KerbalJeb/ECE299DesignProject/README.md

# ECE299DesignProject


An Arduino Uno power alarm clock, complated as part of ECE299 at UVic.

The PCB desing files can be viewed online at:[CADLAB.io](https://cadlab.io/project/23071).
