KerbalJeb/ECE299DesignProject/Report/Schematic Arduino2.PNG

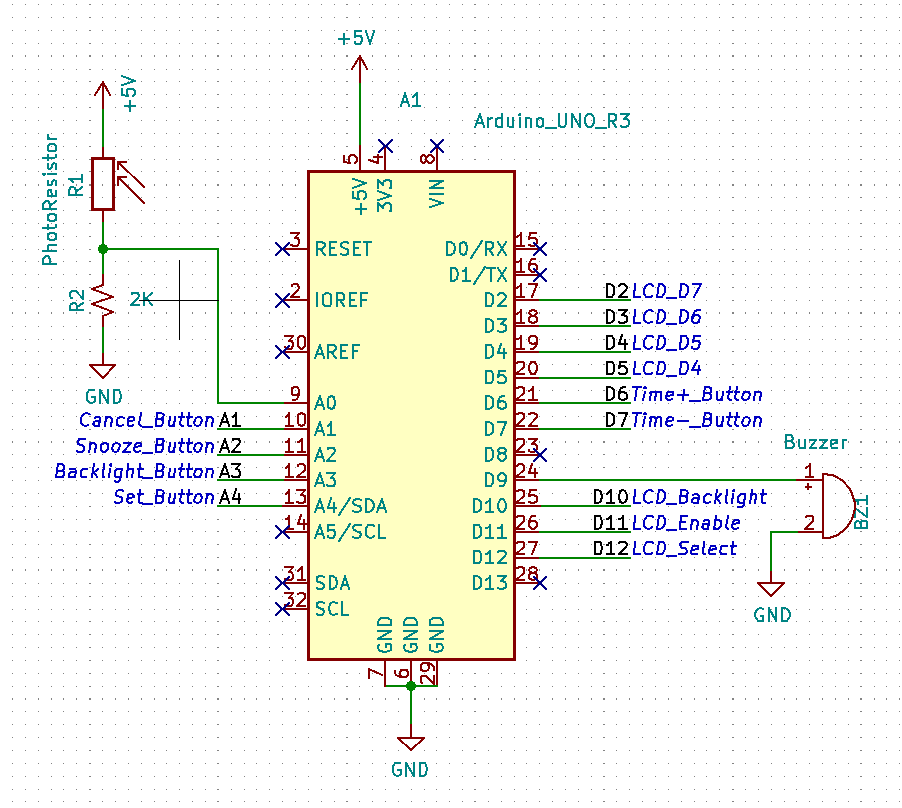
Report/Schematic Arduino2.PNG
