KerbalJeb/ECE299DesignProject/Report/Schematic Arduino.PNG

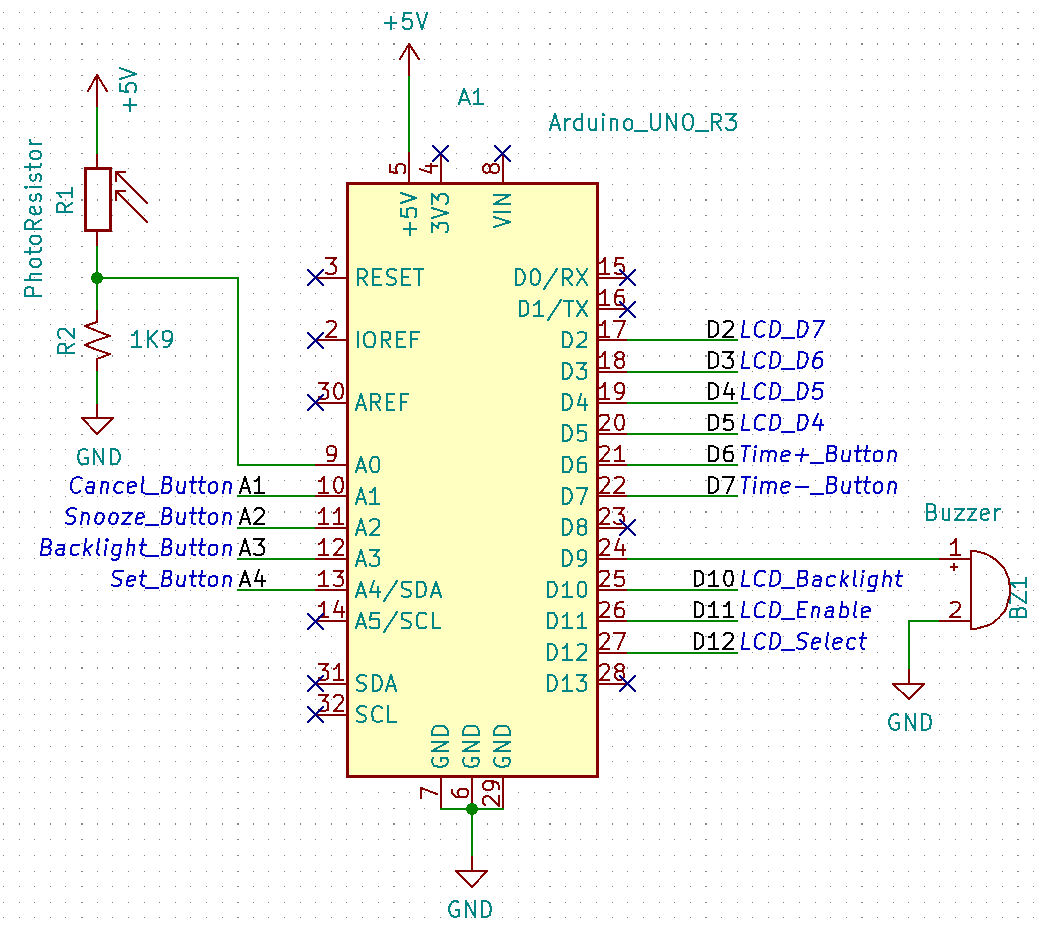
Report/Schematic Arduino.PNG
