KerbalJeb/ECE299DesignProject/Report/Schematic General.PNG

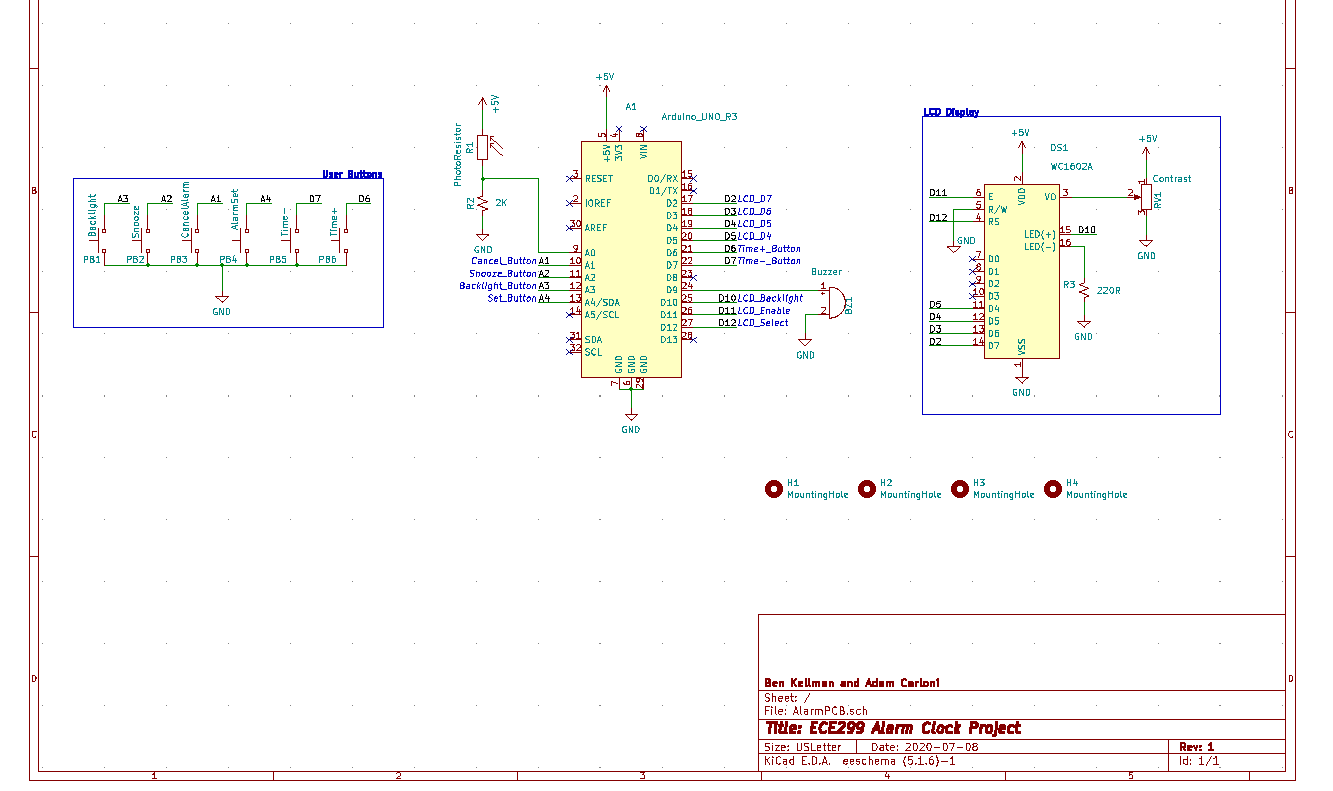
Report/Schematic General.PNG
