KerbalJeb/ECE299DesignProject/Report/Schematic LCD Drawing.PNG

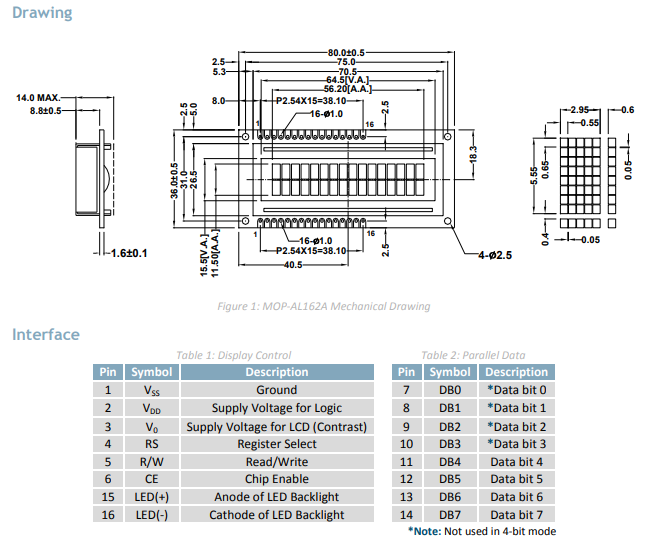
Report/Schematic LCD Drawing.PNG
