KerbalJeb/ECE299DesignProject/Report/Schematic LCD.PNG

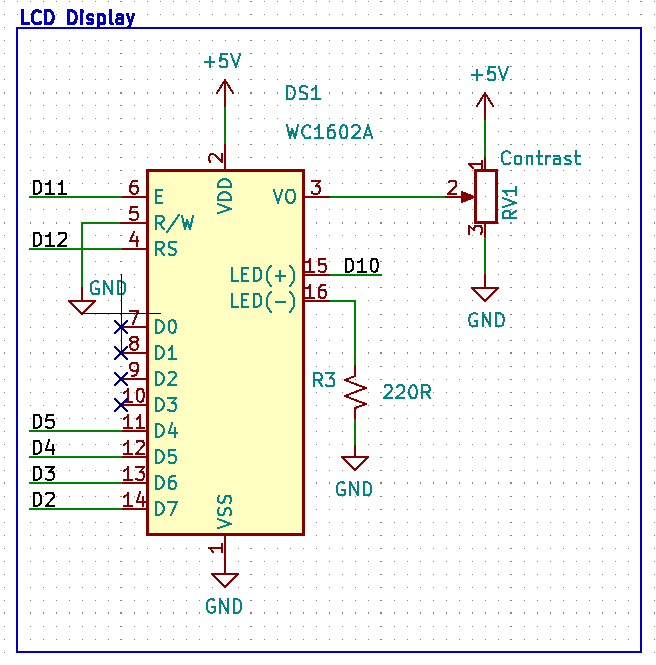
Report/Schematic LCD.PNG
