KerbalJeb/ECE299DesignProject/Report/Schematic PB.PNG

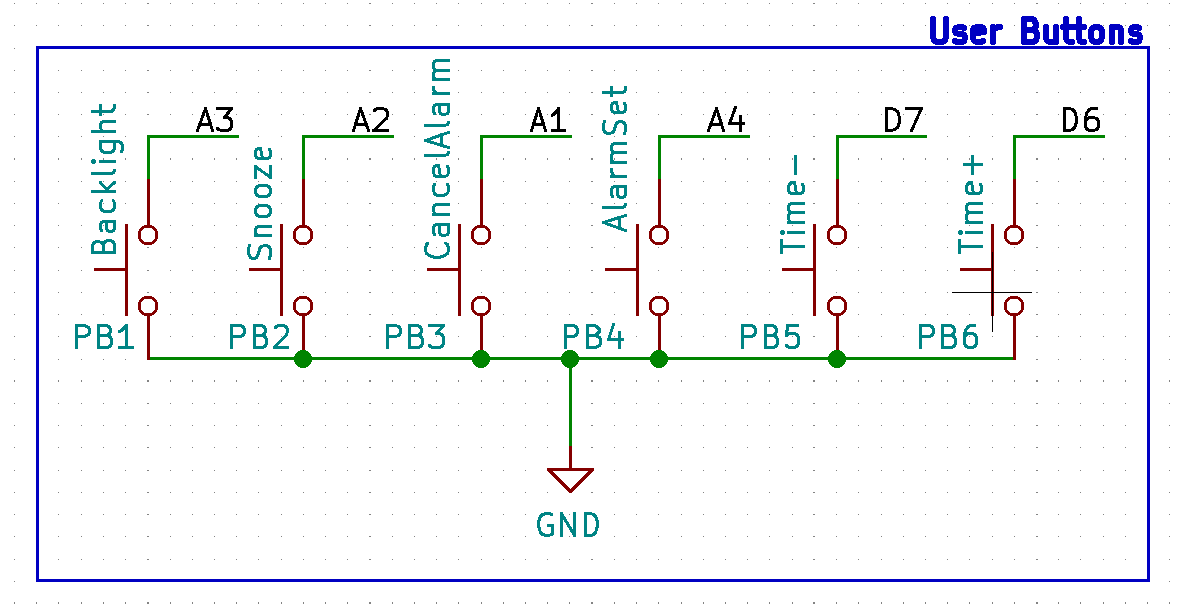
Report/Schematic PB.PNG
