KerbalJeb/ECE299DesignProject/Report/Schematic.png

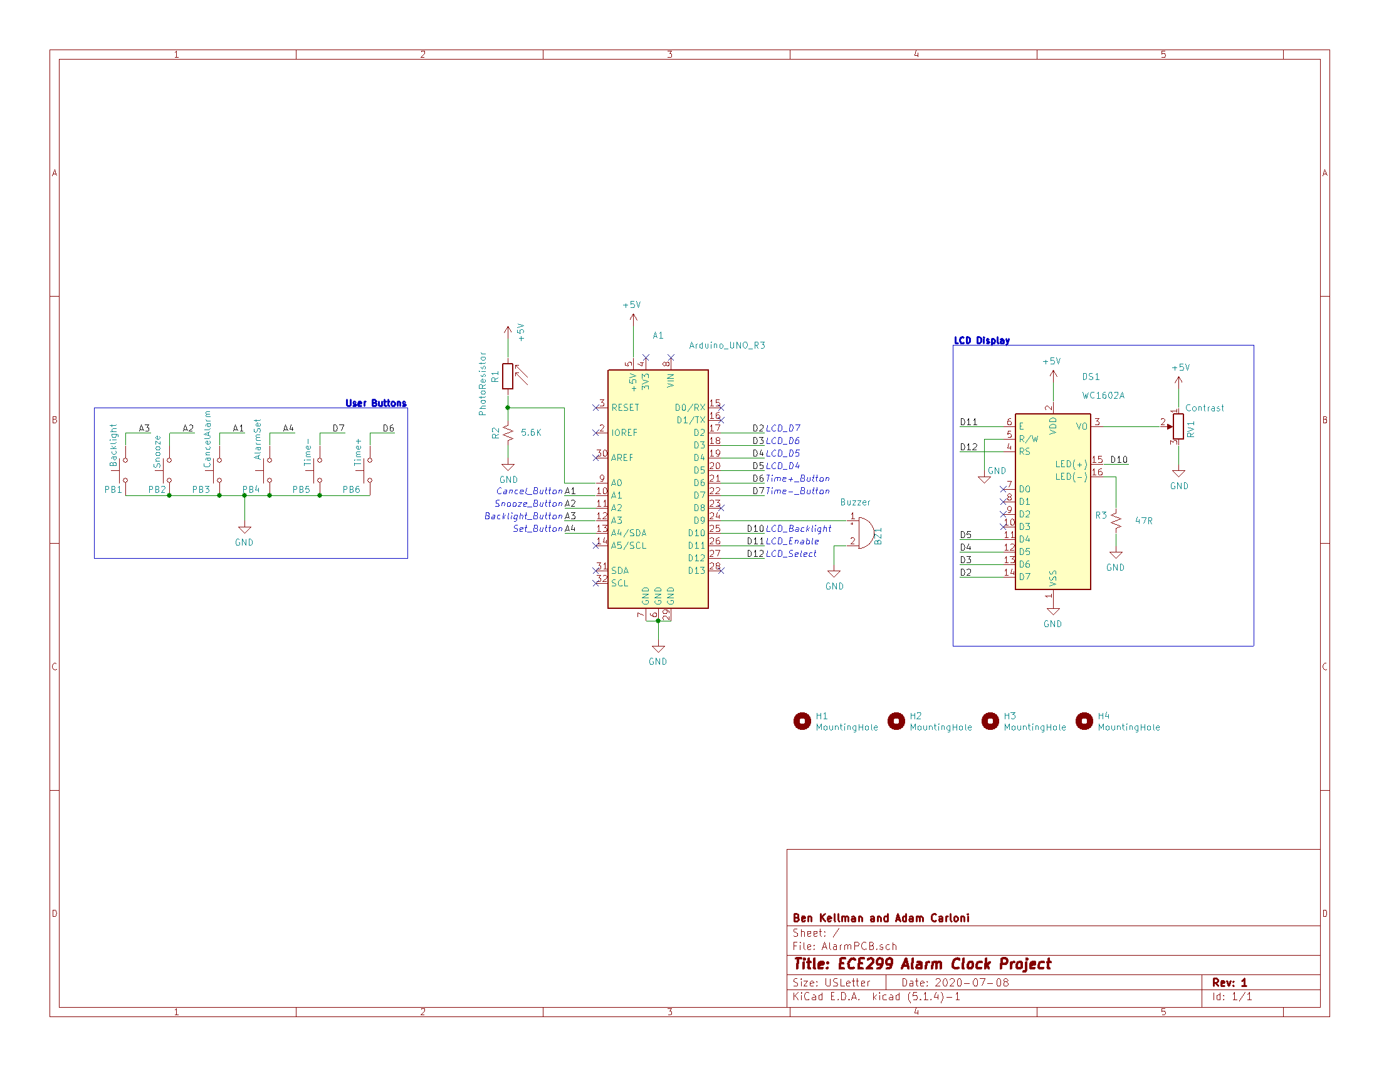
Report/Schematic.png
