KerbalJeb/ECE299DesignProject/AlarmPCB/AlarmPCB.kicad_pcb

## KiCad design AlarmPCB/AlarmPCB.kicad_pcb (2020-08-27)

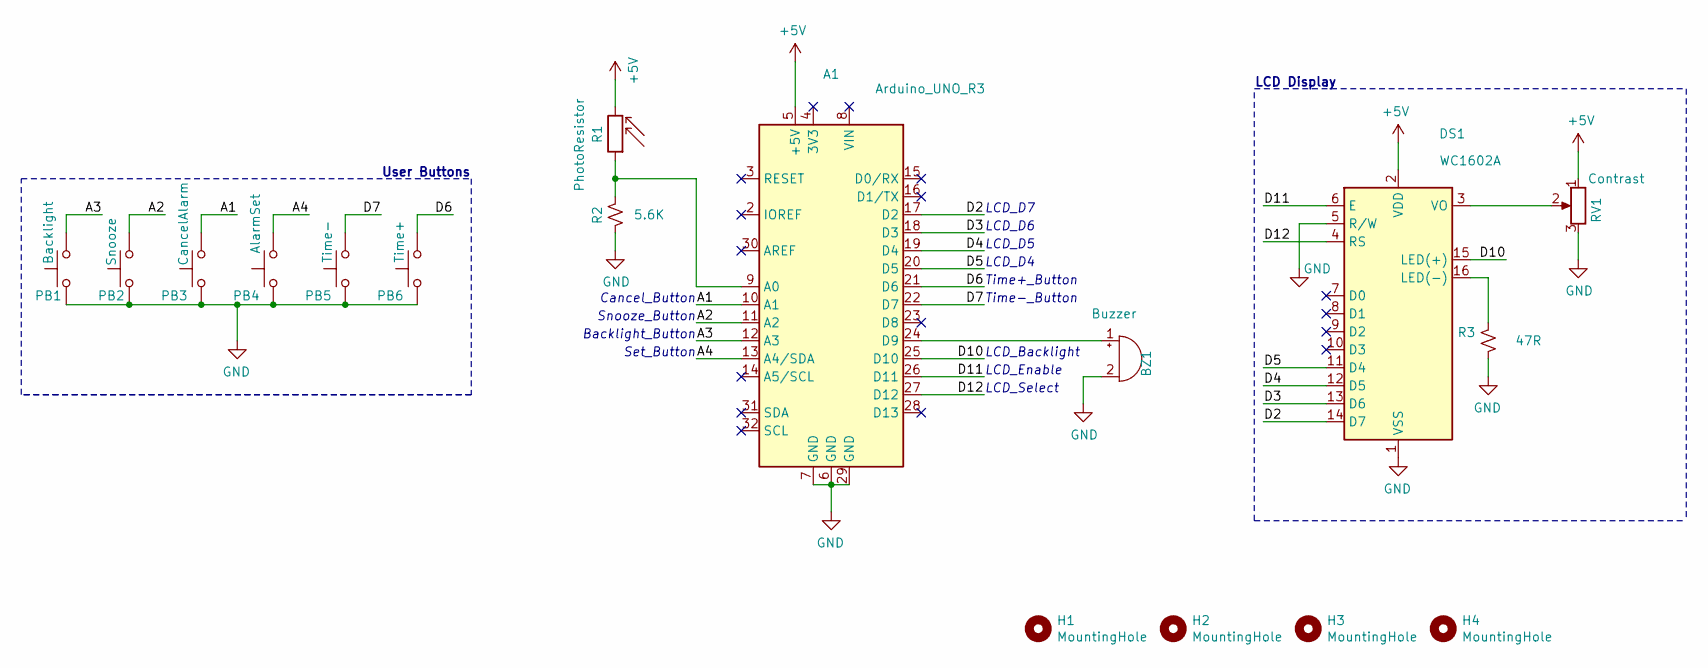
[picture p17: schematic AlarmPCB.sch, ECE299 Alarm Clock Project]

Parts:
A1: Arduino_UNO_R3
BZ1: Buzzer; Buzzer_D14mm_H7mm_P10mm
DS1: WC1602A
H1, H2, H3, H4: MountingHole; MountingHole_3.2mm_M3
PB1: Backlight; SW_TH_Tactile_Omron_B3F-10xx
PB2: Snooze; PinHeader_1x02_P2.54mm_Vertical
PB3: CancelAlarm; PinHeader_1x02_P2.54mm_Vertical
PB4: AlarmSet; SW_TH_Tactile_Omron_B3F-10xx
PB5: Time-; SW_TH_Tactile_Omron_B3F-10xx
PB6: Time+; SW_TH_Tactile_Omron_B3F-10xx
R1: PhotoResistor; PinHeader_1x02_P2.54mm_Vertical
R2: 5.6K; R_Axial_DIN0309_L9.0mm_D3.2mm_P12.70mm_Horizontal
R3: 47R; R_Axial_DIN0309_L9.0mm_D3.2mm_P12.70mm_Horizontal
RV1: Contrast; Potentiometer_P120PK-Y25BR10K

Connections:
+5V: A1.5 (+5V), DS1.2 (VDD), R1.2, RV1.1
/A1: A1.10 (A1), PB3.1
/A2: A1.11 (A2), PB2.1
/A3: A1.12 (A3), PB1.1
/A4: A1.13 (A4/SDA), PB4.1
/D2: A1.17 (D2), DS1.14 (D7)
/D3: A1.18 (D3), DS1.13 (D6)
/D4: A1.19 (D4), DS1.12 (D5)
/D5: A1.20 (D5), DS1.11 (D4)
/D6: A1.21 (D6), PB6.1
/D7: A1.22 (D7), PB5.1
/D10: A1.25 (D10), DS1.15 (LED(+))
/D11: A1.26 (D11), DS1.6 (E)
/D12: A1.27 (D12), DS1.4 (RS)
GND: A1.6 (GND), A1.7 (GND), A1.29 (GND), BZ1.2 (+), DS1.1 (VSS), DS1.5 (R/W), PB1.2, PB2.2, PB3.2, PB4.2, PB5.2, PB6.2, R2.1, R3.2, RV1.3
unnamed: A1.9 (A0), R1.1, R2.2
unnamed: A1.24 (D9), BZ1.1 (-)
unnamed: DS1.3 (VO), RV1.2
unnamed: DS1.16 (LED(-)), R3.1

Notes on the sheet:
LCD Display
User Buttons
LCD_Enable
LCD_Select
LCD_D7
LCD_D6
LCD_D5
LCD_D4
LCD_Backlight
Time+_Button
Time-_Button
Cancel_Button
Snooze_Button
Backlight_Button
Set_Button

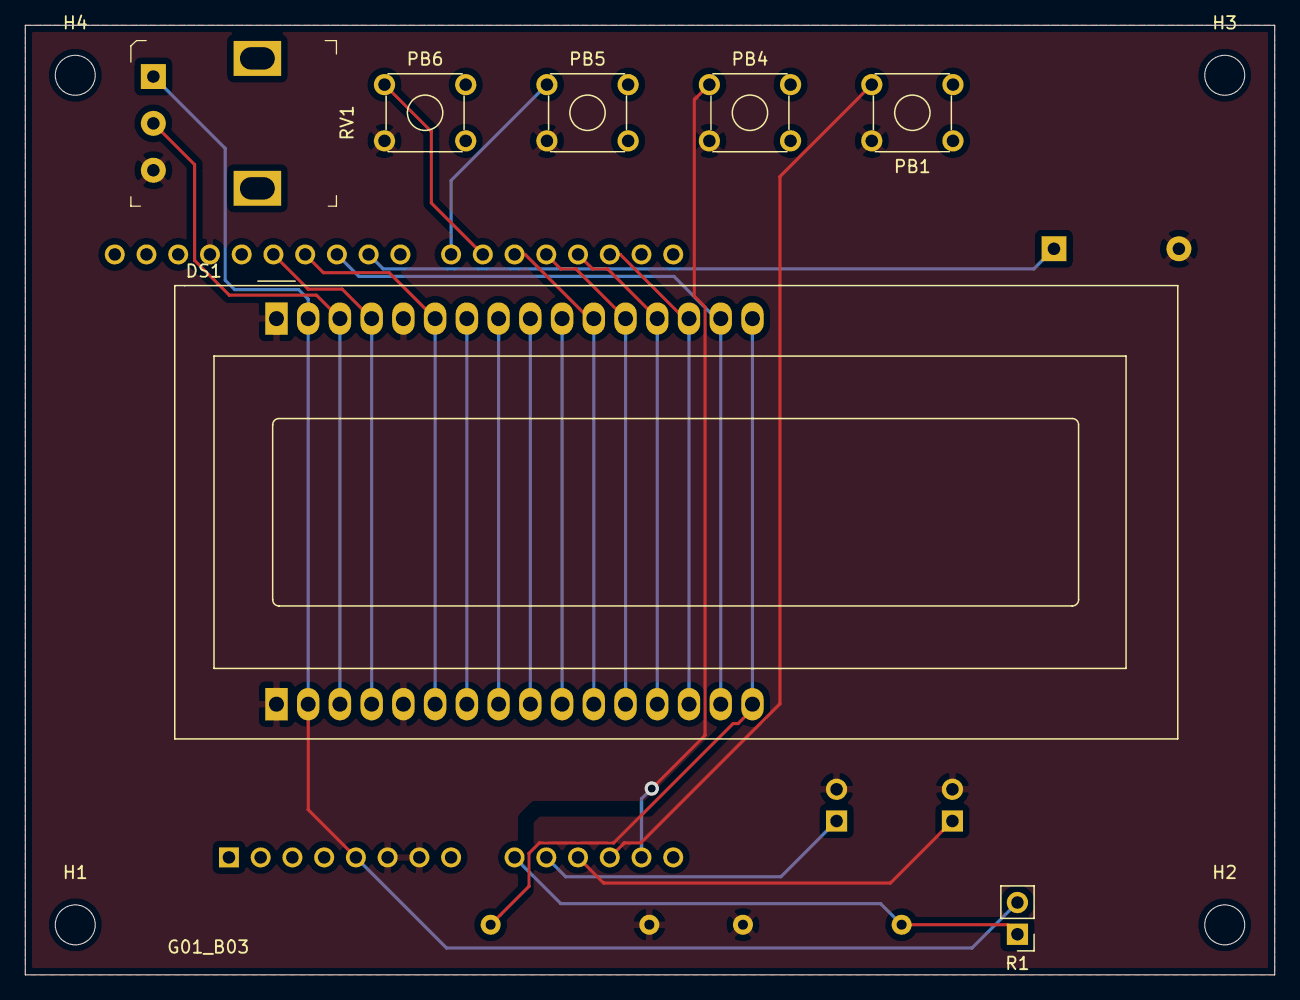
[picture p18: board AlarmPCB.kicad_pcb from above]

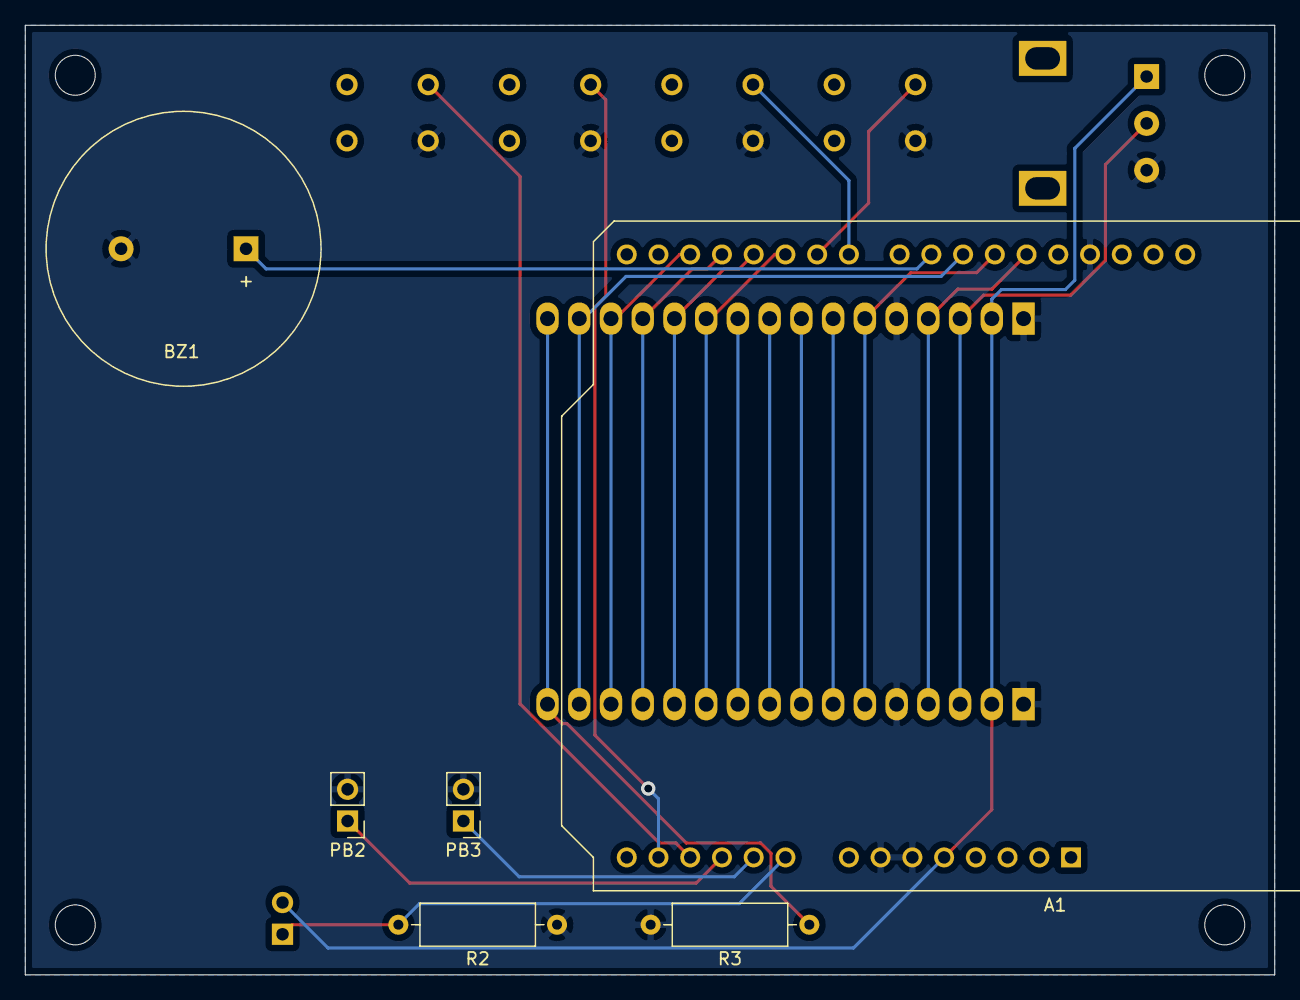
[picture p19: board AlarmPCB.kicad_pcb from below]

Board: 2 copper layers, 100.0 x 76.0 mm, 17 parts (6 on the bottom side), 19 nets.
