KerbalJeb/ECE299DesignProject/(commit log)

2020-07-03 Added Arduino and display to schematic
    [AlarmPCB.sch]
2020-07-04 Complining Arduino Code on commit
2020-07-04 Removed Install boards line
2020-07-04 Making sure build fails correctly
    [AlarmCode.ino]
2020-07-08 Addded LCD
    [AlarmPCB.sch]
2020-07-08 Added test
    [AlarmPCB.sch]
2020-07-08 Added initial circuit layout
    [AlarmPCB.sch]
2020-07-09 Changed look of sch
    [AlarmPCB.sch]
2020-07-11 Cleaned up layout of sch
    [AlarmPCB.sch]
2020-07-15 Rough Draft
    [AlarmPCB.kicad_pcb, AlarmPCB.sch]
2020-07-15 Fixed push-button numbering
    [AlarmPCB.sch]
2020-07-19 Made PCB
    [AlarmPCB.kicad_pcb, AlarmPCB.sch]
2020-07-19 Updated arduino config
2020-07-24 Updated PCB GND Layer
    [AlarmPCB.kicad_pcb, AlarmPCB.sch]
2020-07-25 PCB Dimensions
    [AlarmPCB.kicad_pcb, AlarmPCB.sch]
2020-07-26 PCB revisions
    [AlarmPCB.kicad_pcb]
2020-07-26 Updated Footprints
    [AlarmPCB.kicad_pcb, AlarmPCB.sch]
2020-07-26 Revert "Updated Footprints"
    This reverts commit dd3b0c72e674ffb159cfd3c8d42ceca2805da80f.
2020-07-26 Updated Pot footprint
    [AlarmPCB.kicad_pcb, AlarmPCB.sch]
2020-07-26 PCB rev
    [AlarmPCB.kicad_pcb, AlarmPCB.sch]
2020-07-27 Final PCB
    [AlarmPCB.kicad_pcb]
2020-07-28 Fixed snooze display bug
    [AlarmCode.ino]
2020-07-29 Fixed display problem when leaving back-light menu
    [AlarmCode.ino]
2020-08-18 Updated Resistor Values
    [AlarmPCB.sch]
2020-08-18 Fixed Short
    [AlarmPCB.kicad_pcb]
2020-08-18 Moved test code to fix build
    [Test.ino]
2020-08-26 Fixed some UI buttons not working after alarm trigger
    [AlarmCode.ino]
